wro26-teamapex/wro2026_fe_apex/matlab/Efficiency Sensitivity.png

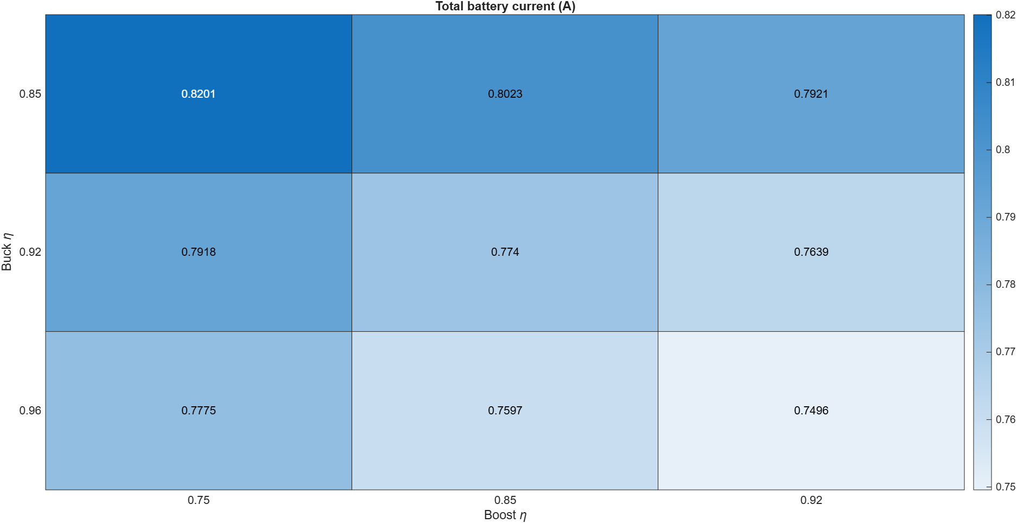
matlab/Efficiency Sensitivity.png
