wro26-teamapex/wro2026_fe_apex/matlab/Per-Lap Depletion.png

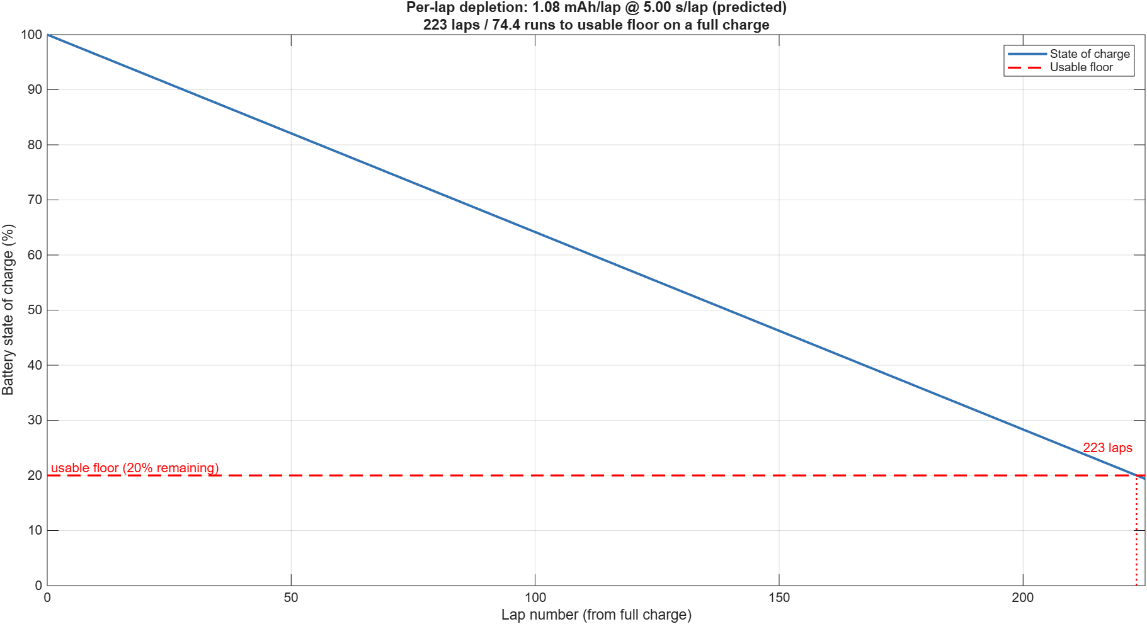
matlab/Per-Lap Depletion.png
