wro26-teamapex/wro2026_fe_apex/matlab/Power Distribution.png

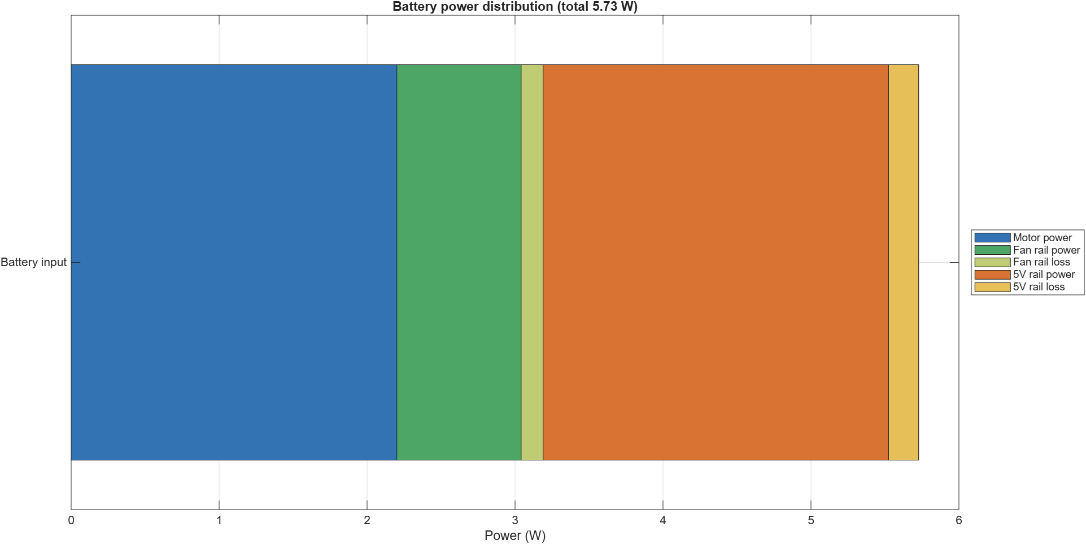
matlab/Power Distribution.png
