wro26-teamapex/wro2026_fe_apex/matlab/Runtime Comparison.png

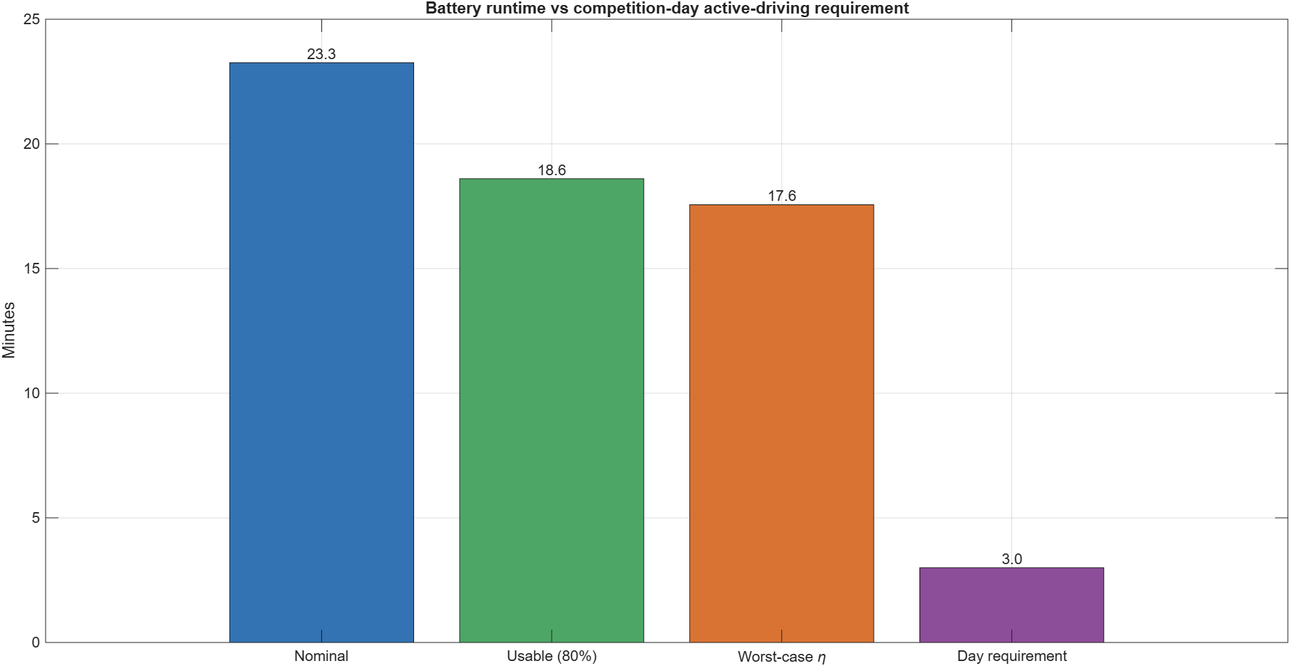
matlab/Runtime Comparison.png
