wro26-teamapex/wro2026_fe_apex/matlab/Voltage & Lap Time vs SoC.png

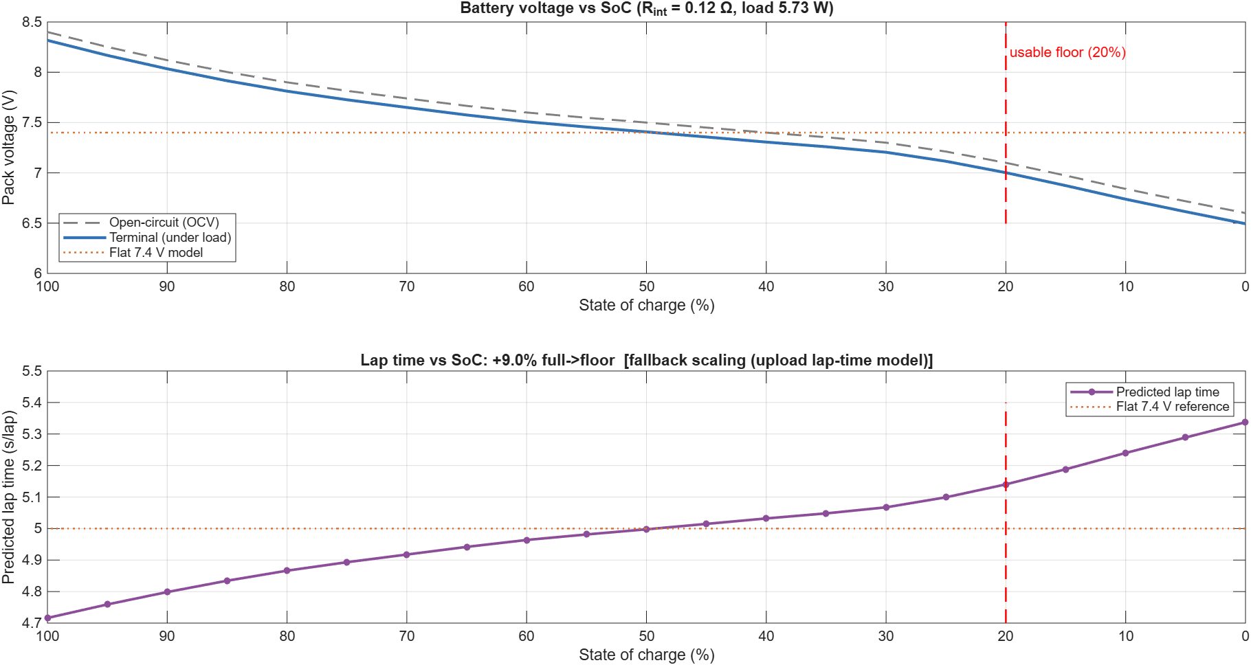
matlab/Voltage & Lap Time vs SoC.png
