wro26-teamapex/wro2026_fe_apex/resources/fig(2.2.1).png

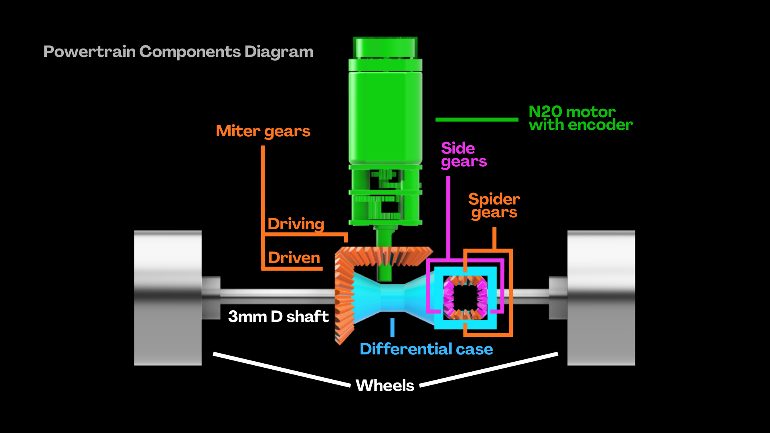
resources/fig(2.2.1).png
