wro26-teamapex/wro2026_fe_apex/(list of files, cad)

Other CAD files:
model/Bevel Gear v1.f3d
model/Differential side gears v1.f3d
model/Electronic Components (v1) (1).f3d
model/Electronic Components (v1) (2).f3d
model/Spider Gear v1.f3d
