wro26-teamapex/wro2026_fe_apex/(commit log)

2026-06-14 Electronic components 3D imitation (v1)
    [Electronic Components (v1).f3d]
2026-06-15 Chassis Design 3D model (v1)
2026-06-18 Chassis Design 3D model (v2)
    Finalized chassis upper body
2026-06-19 Bevel Gear 3D model (v1)
    [Bevel Gear v1.f3d]
2026-06-19 Bevel Gear 2 3D model (v1)
    [Bevel Gear 2 linked to differential cage v1.f3d]
2026-06-19 Spider Gear 3D model (v1)
    [Spider Gear v1.f3d]
2026-06-19 Differential side gears 3D model (v1)
    [Differential side gears v1.f3d]
2026-06-20 Fix typo in README regarding ESP32-S3 functionality
    Corrected a typo in the description of the control logic.
2026-06-20 Enhance README with robot images and PRIMES Framework
    Added images and descriptions for robot views and detailed the PRIMES Framework process.
2026-06-23 Rename drivetrain to powertrain and adjust sections
    Updated section titles in the README for clarity.
2026-06-24 Enhance README with N20 motor and steering benefits
    Added details about the N20 motor's advantages over N10 and larger motors, and explained the benefits of Ackermann steering compared to other steering types.
2026-06-24 Create Bevel Gear v1.f3d
    [Bevel Gear v1.f3d]
2026-06-24 Enhance README with N20 motor details and advantages
    Added specifications and advantages of the N20 motor, highlighting its benefits over the N10 and larger motors for improved control and performance.
2026-06-27 Enhance power consumption modeling in README
    Added detailed power consumption modeling section with assumptions, mathematical formulations, subsystem parameters, safety margins, and automated data visualization outputs.
2026-06-27 Enhance README with power modeling and safety details
    Added detailed power consumption modeling and safety margins for subsystems, including battery characteristics and automated data visualization outputs.
2026-06-29 Rename Bevel Gear 2 linked to differential cage v1.f3d to model/Bevel Gear 2 linked to differential cage v1.f3d
    [Bevel Gear 2 linked to differential cage v1.f3d]
2026-06-29 Rename Bevel Gear v1.f3d to model/Bevel Gear v1.f3d
    [Bevel Gear v1.f3d]
2026-06-29 Rename Chassis Design v1.f3d to model/Chassis Design v1.f3d
    [Chassis Design v1.f3d]
2026-06-29 Rename Chassis Design v2.f3d to model/Chassis Design v2.f3d
    [Chassis Design v2.f3d]
2026-06-29 Rename Differential side gears v1.f3d to model/Differential side gears v1.f3d
    [Differential side gears v1.f3d]
2026-06-29 Rename Spider Gear v1.f3d to model/Spider Gear v1.f3d
    [Spider Gear v1.f3d]
2026-06-29 Rename Power Distribution.png to matlab/Power Distribution.png
2026-06-29 Rename Voltage & Lap Time vs SoC.png to matlab/Voltage & Lap Time vs SoC.png
